placewang/HCF460/G294_PROJECT/数据手册/G294_V0.0-20201203.pdf

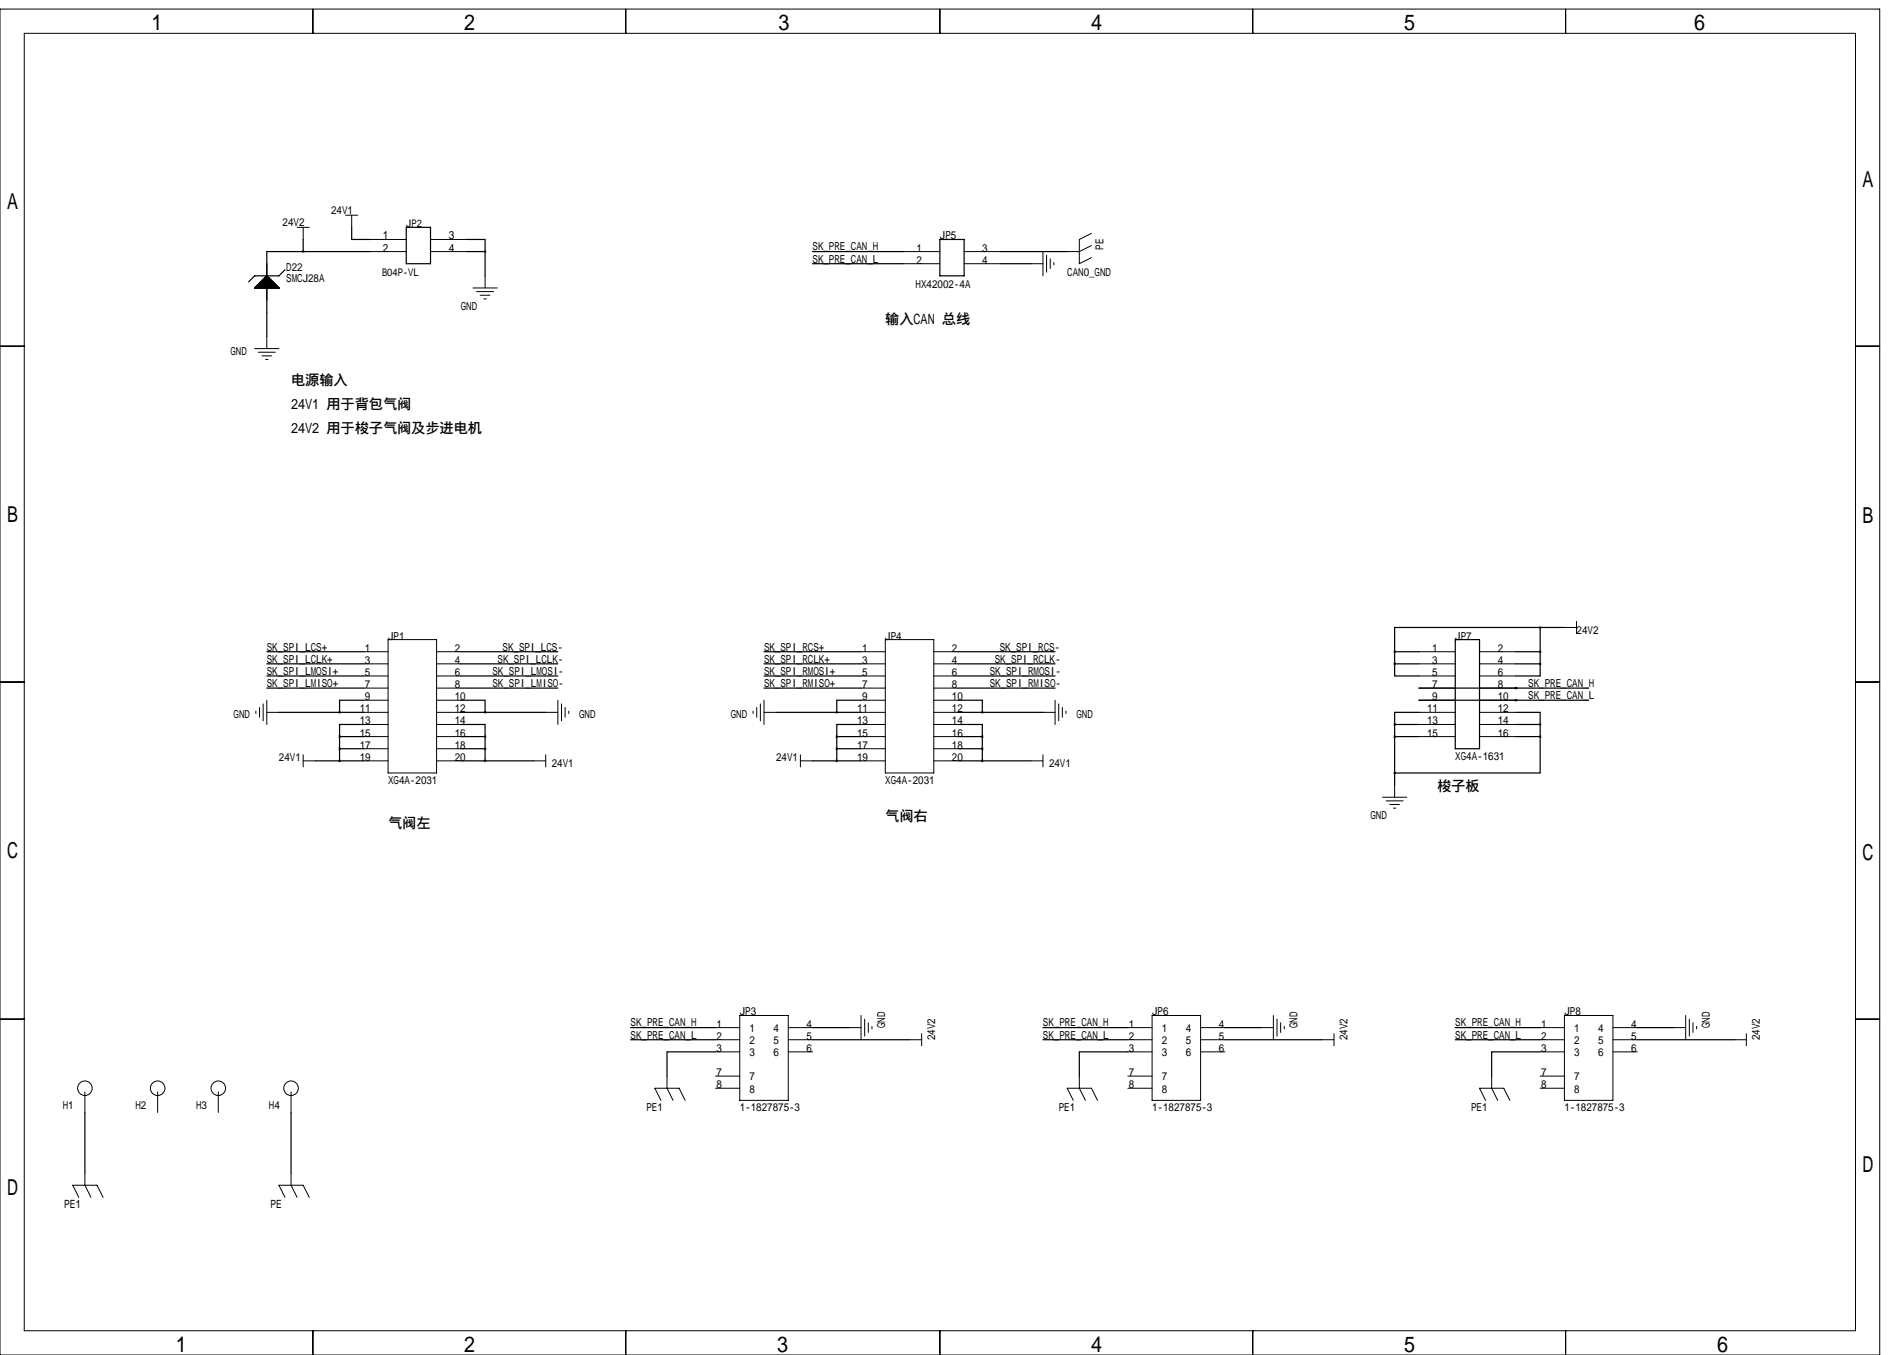
[picture p2: page 1]

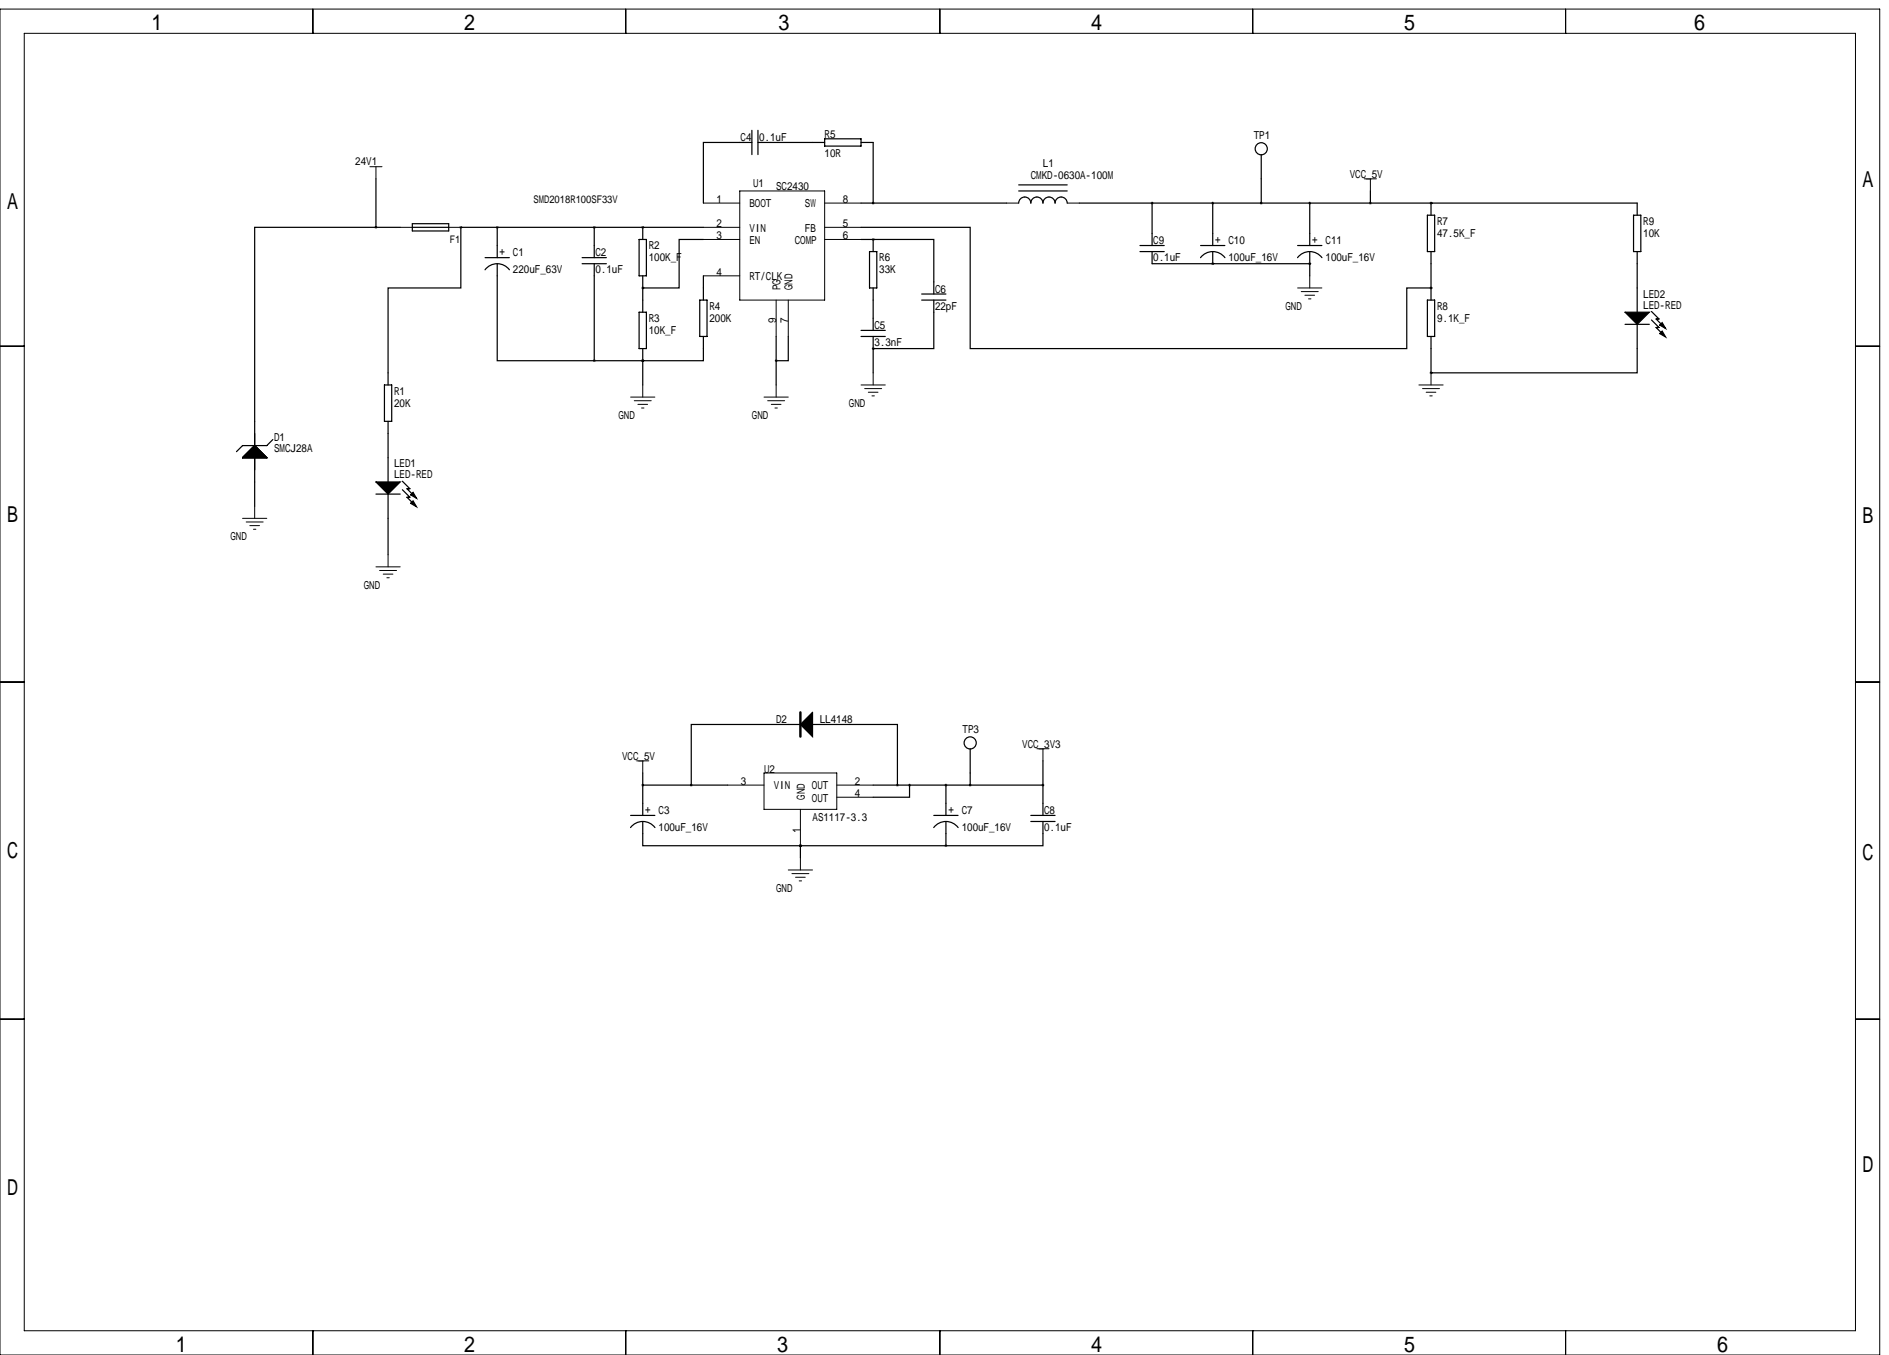
[picture p3: page 2]

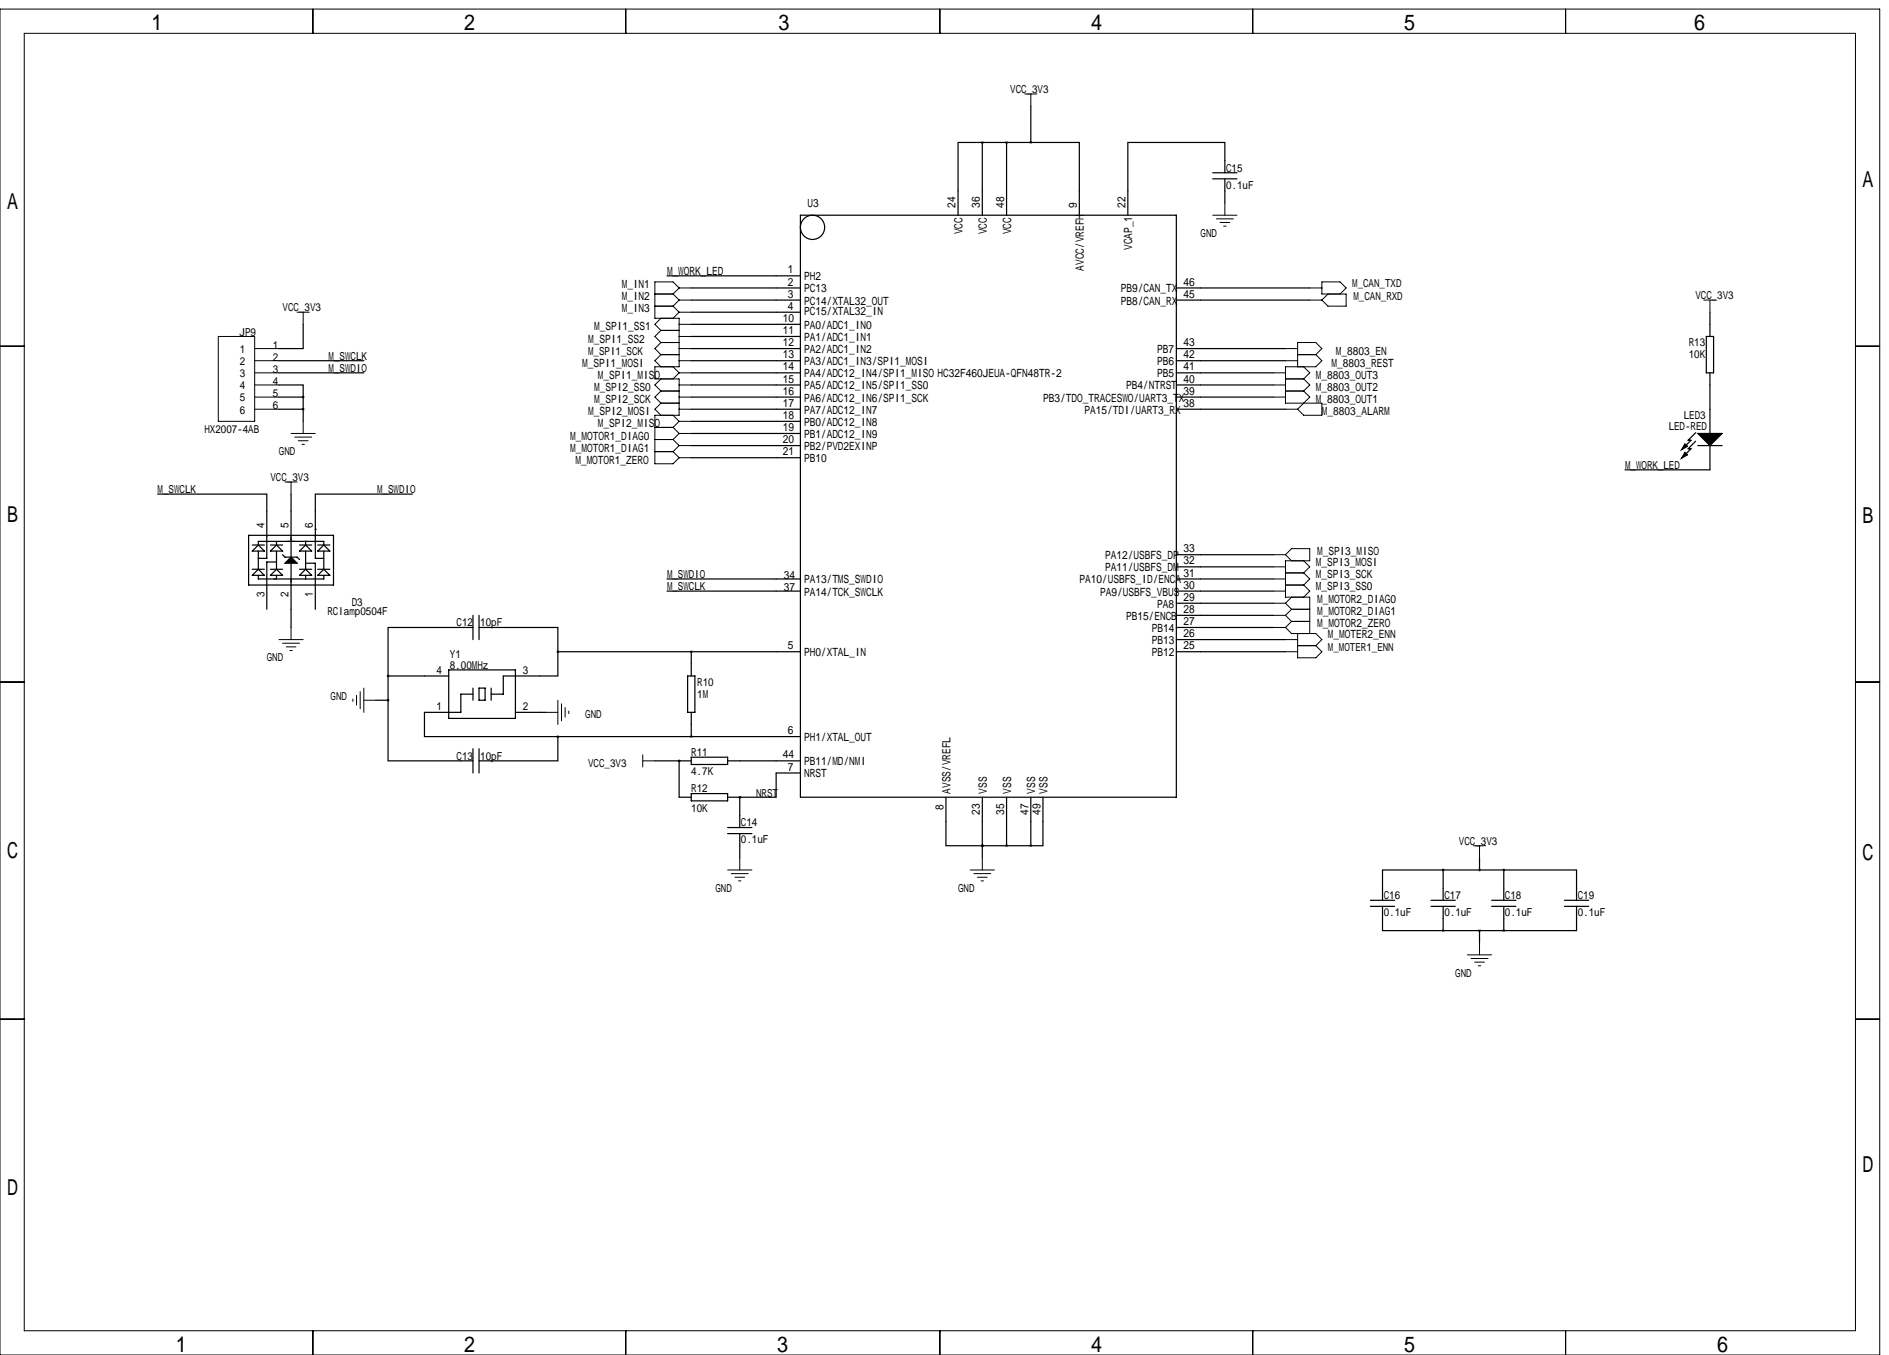
[picture p4: page 3]

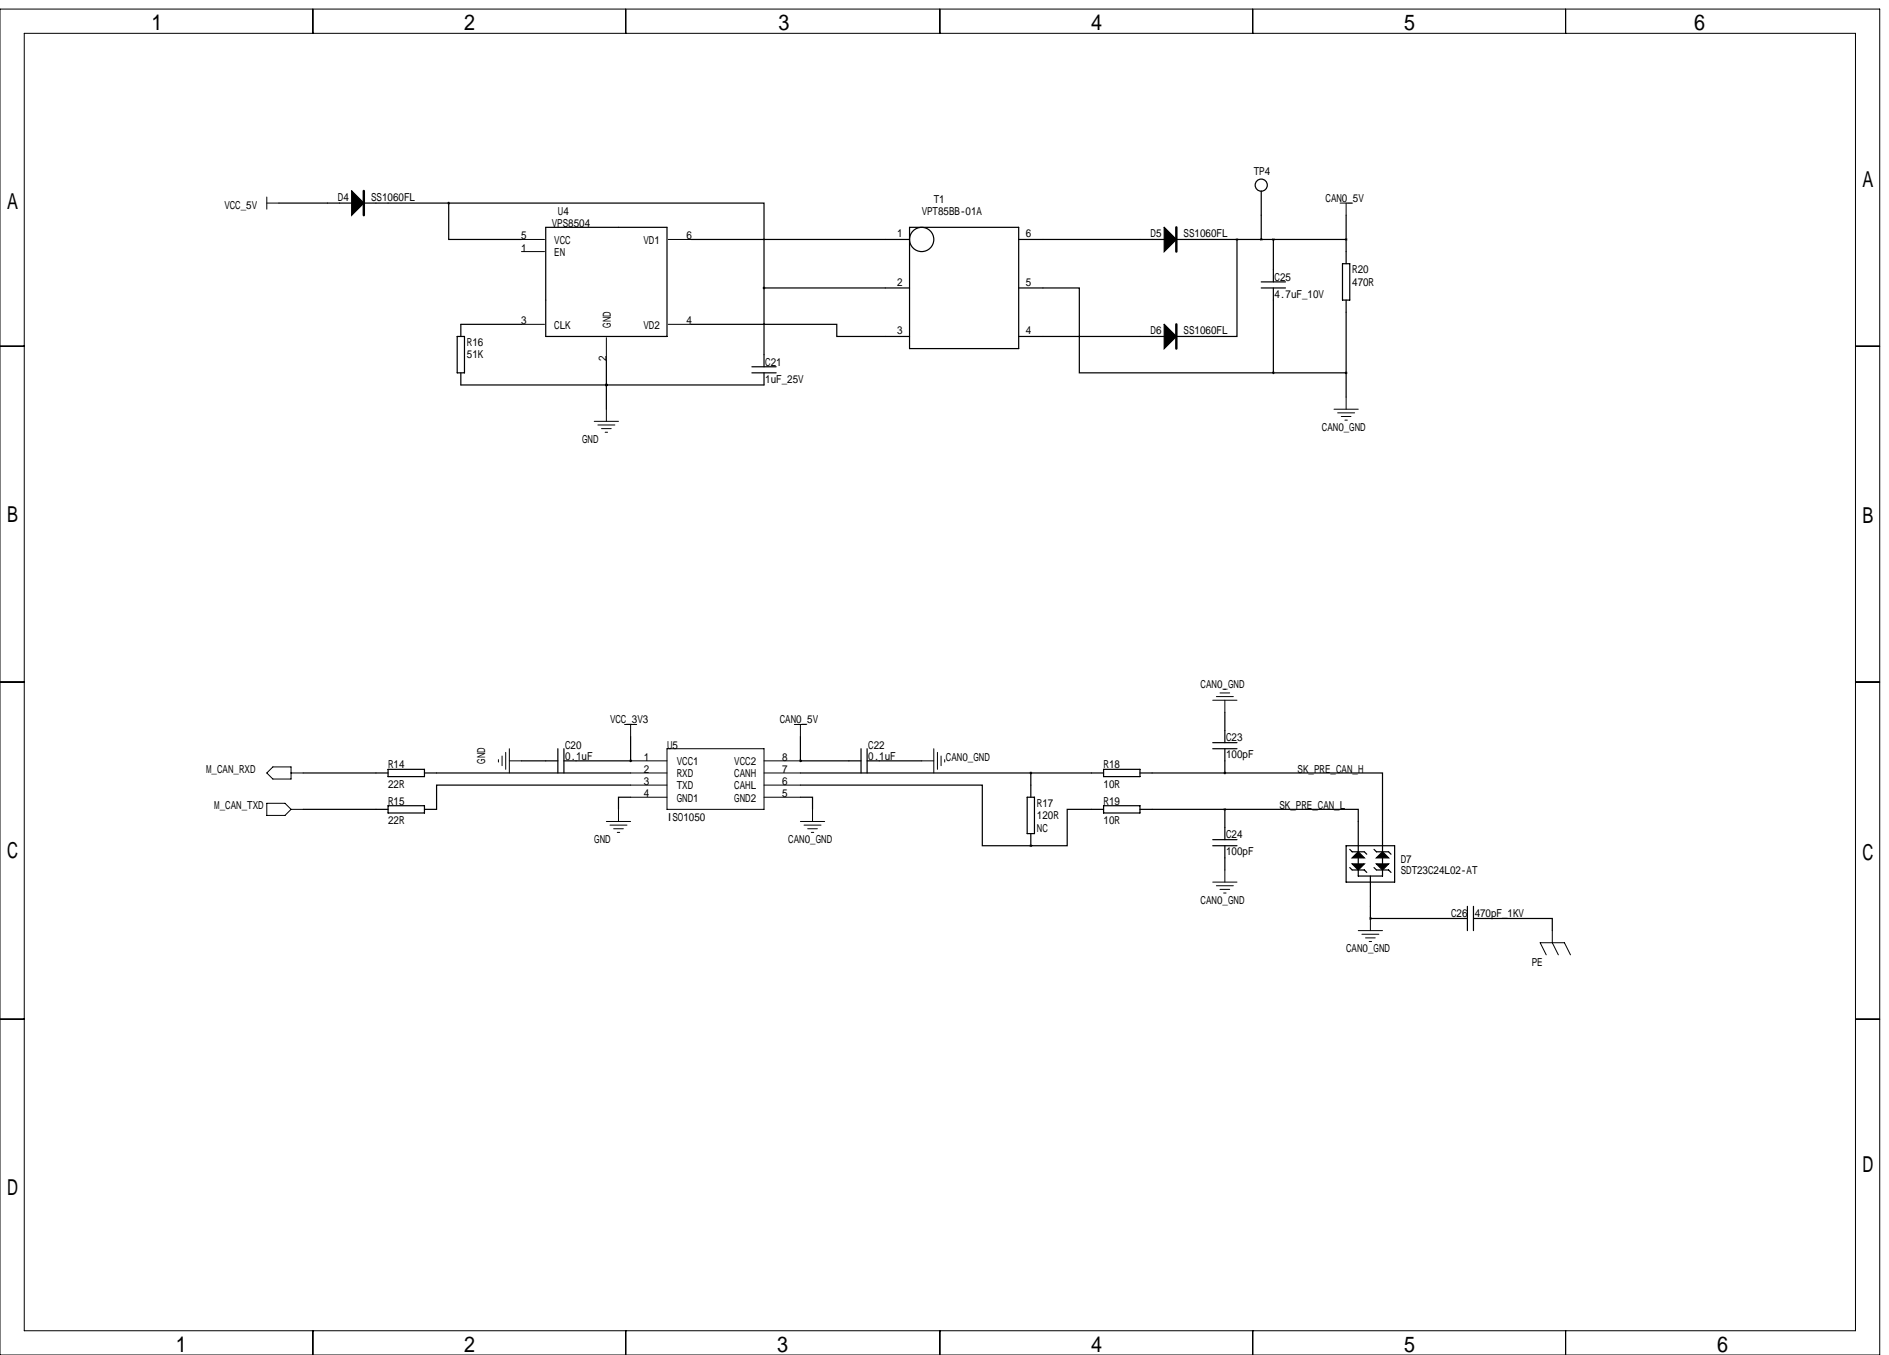
[picture p5: page 4]

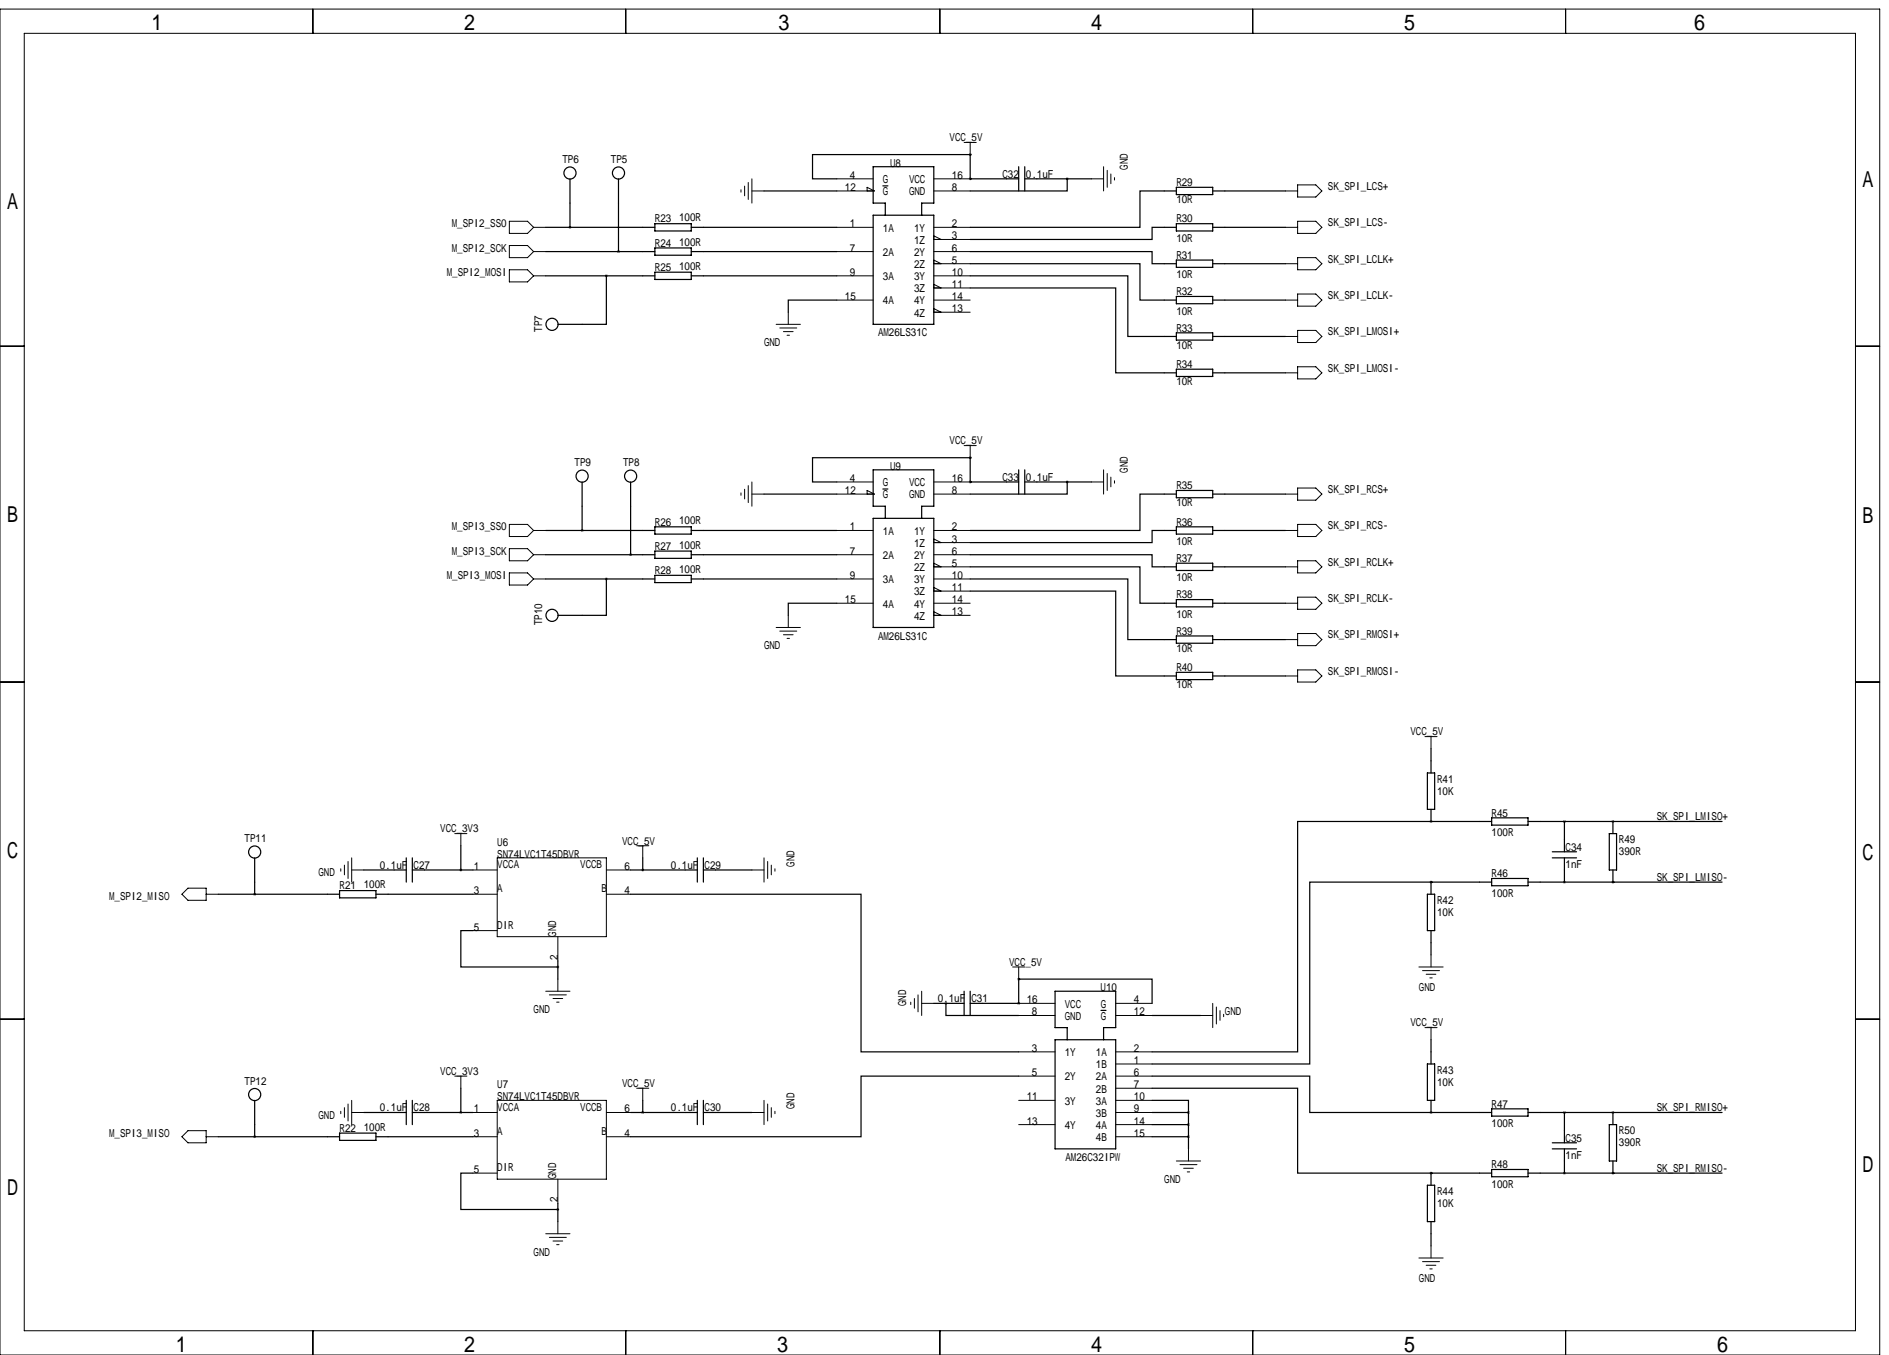
[picture p6: page 5]

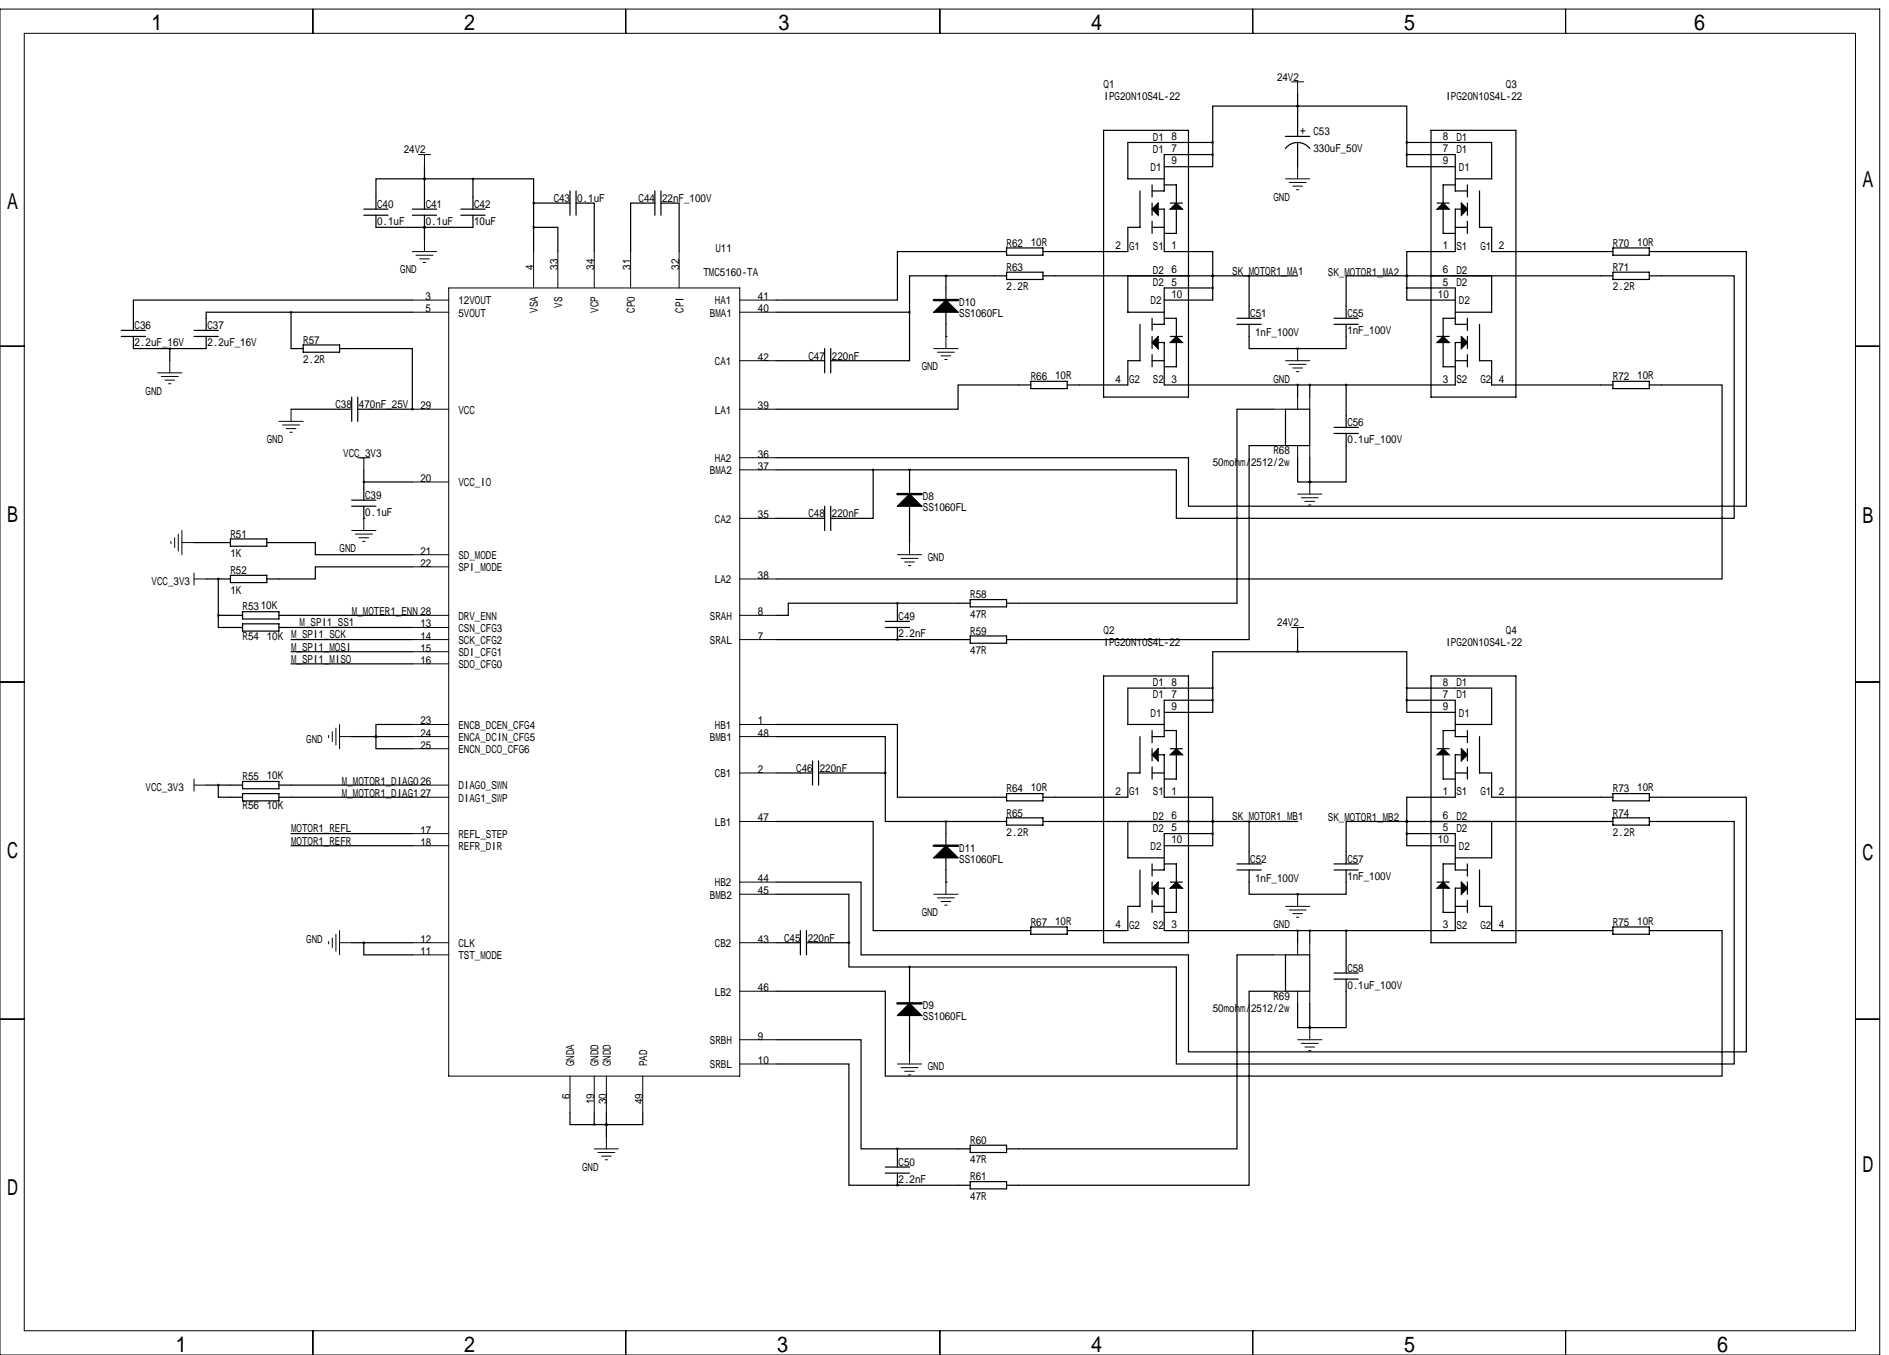
[picture p7: page 6]

24 | | 48
25

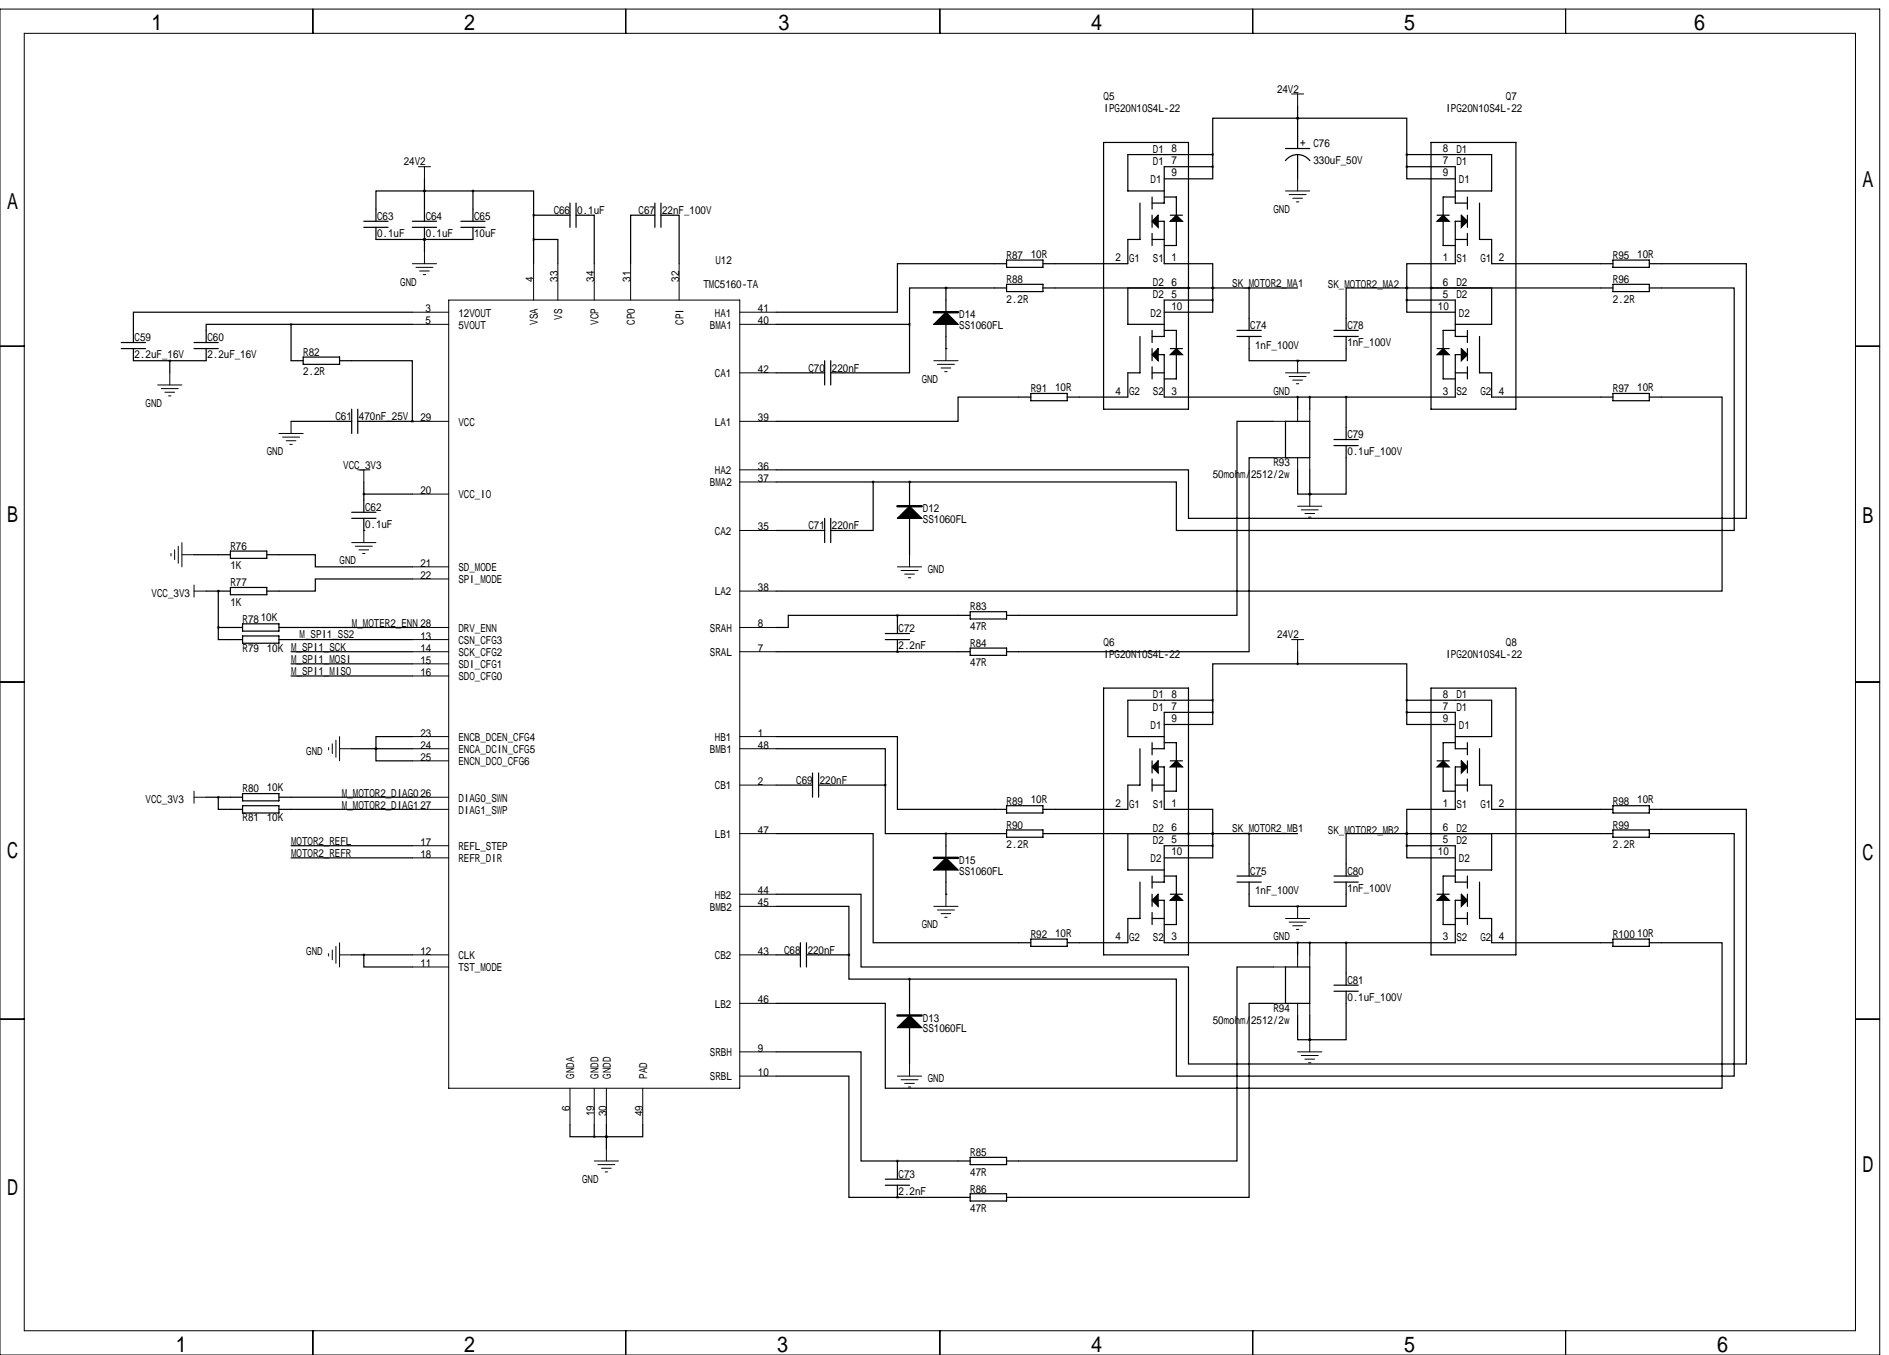
[picture p8: page 7]

GND

24 | | 48
25

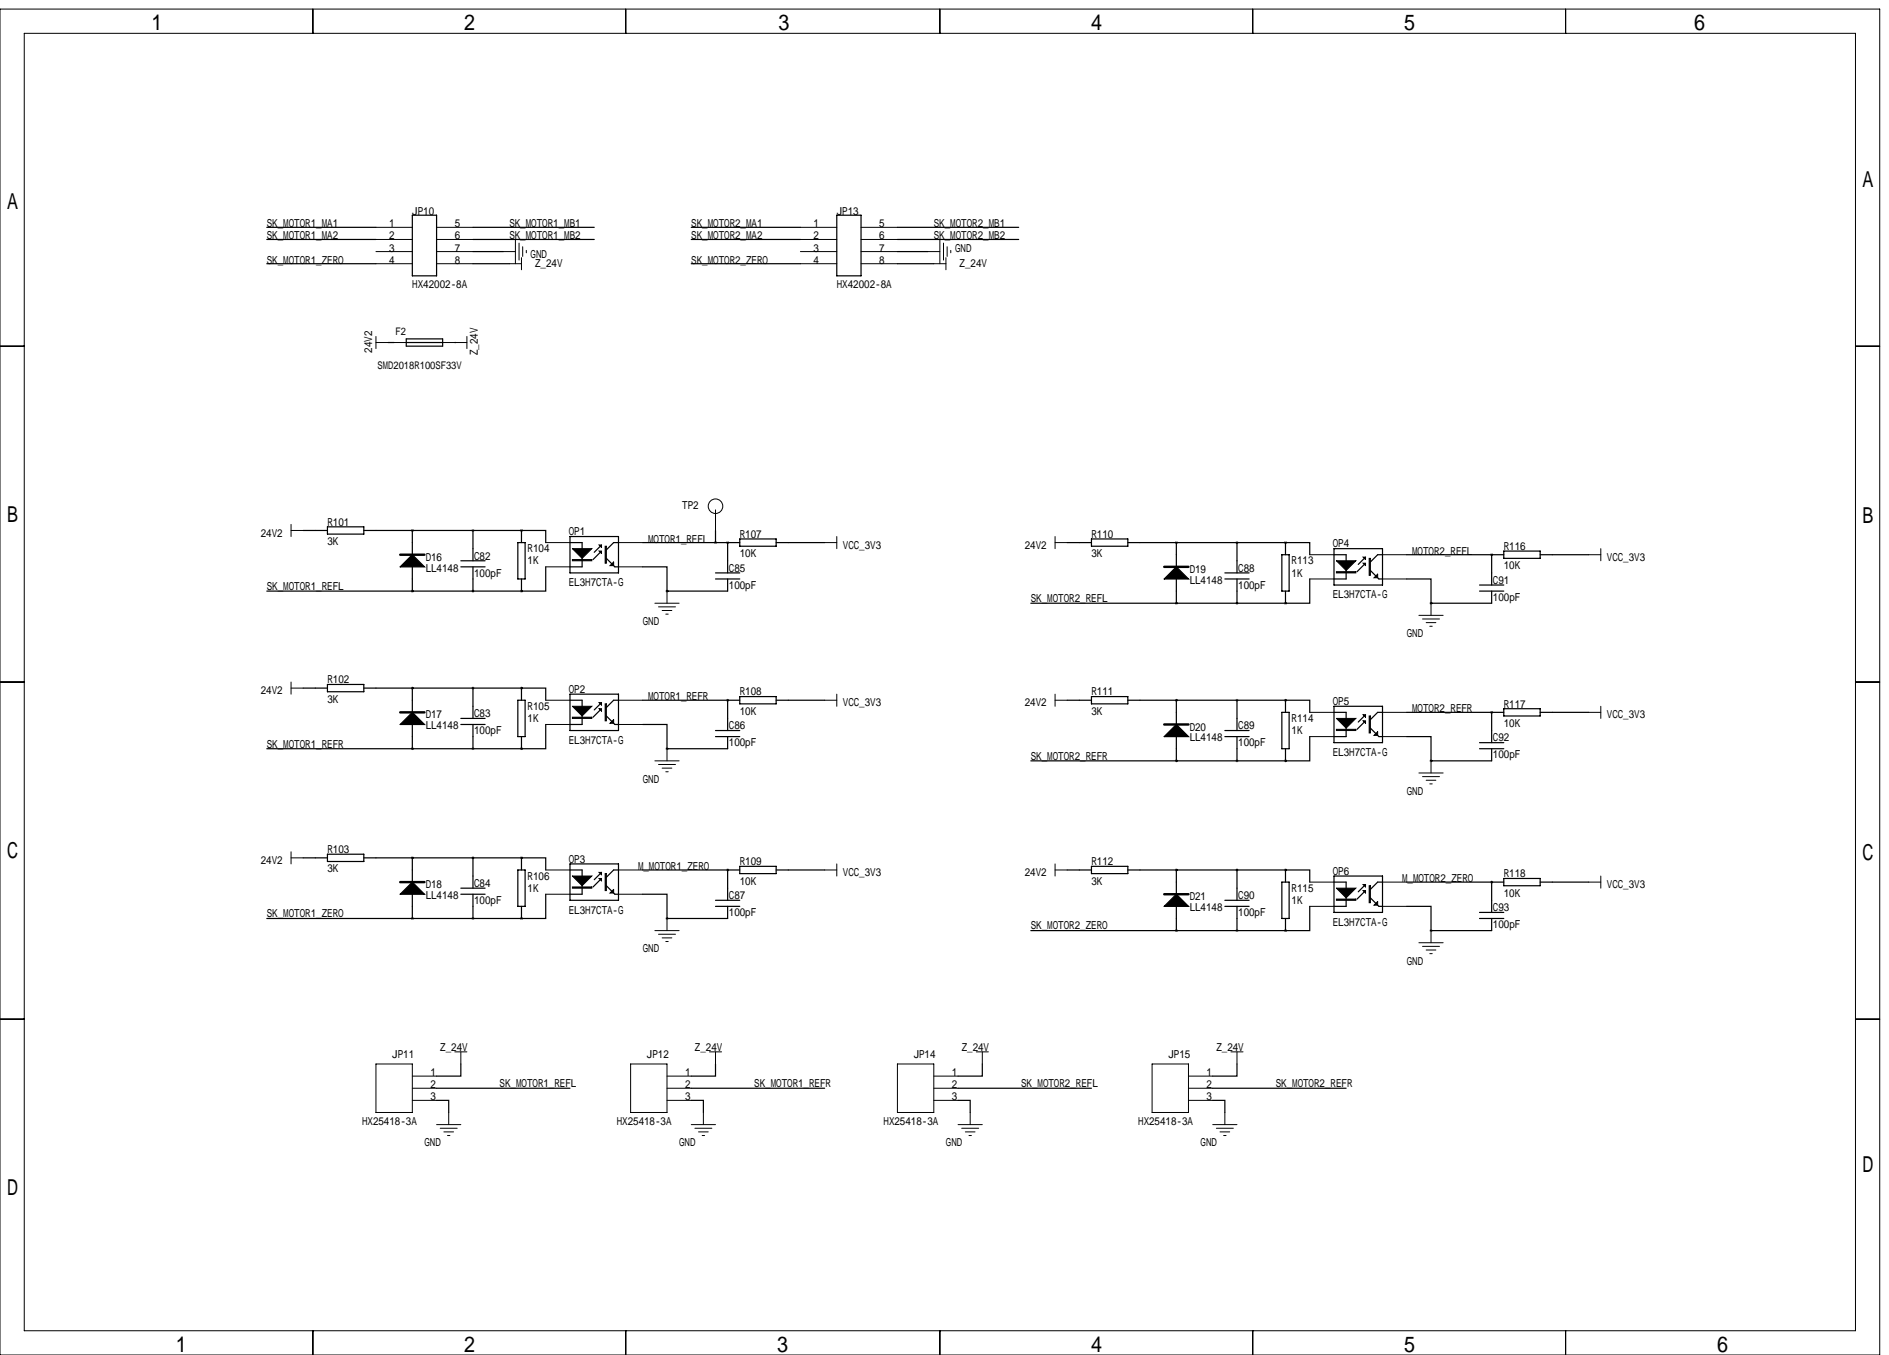
[picture p9: page 8]

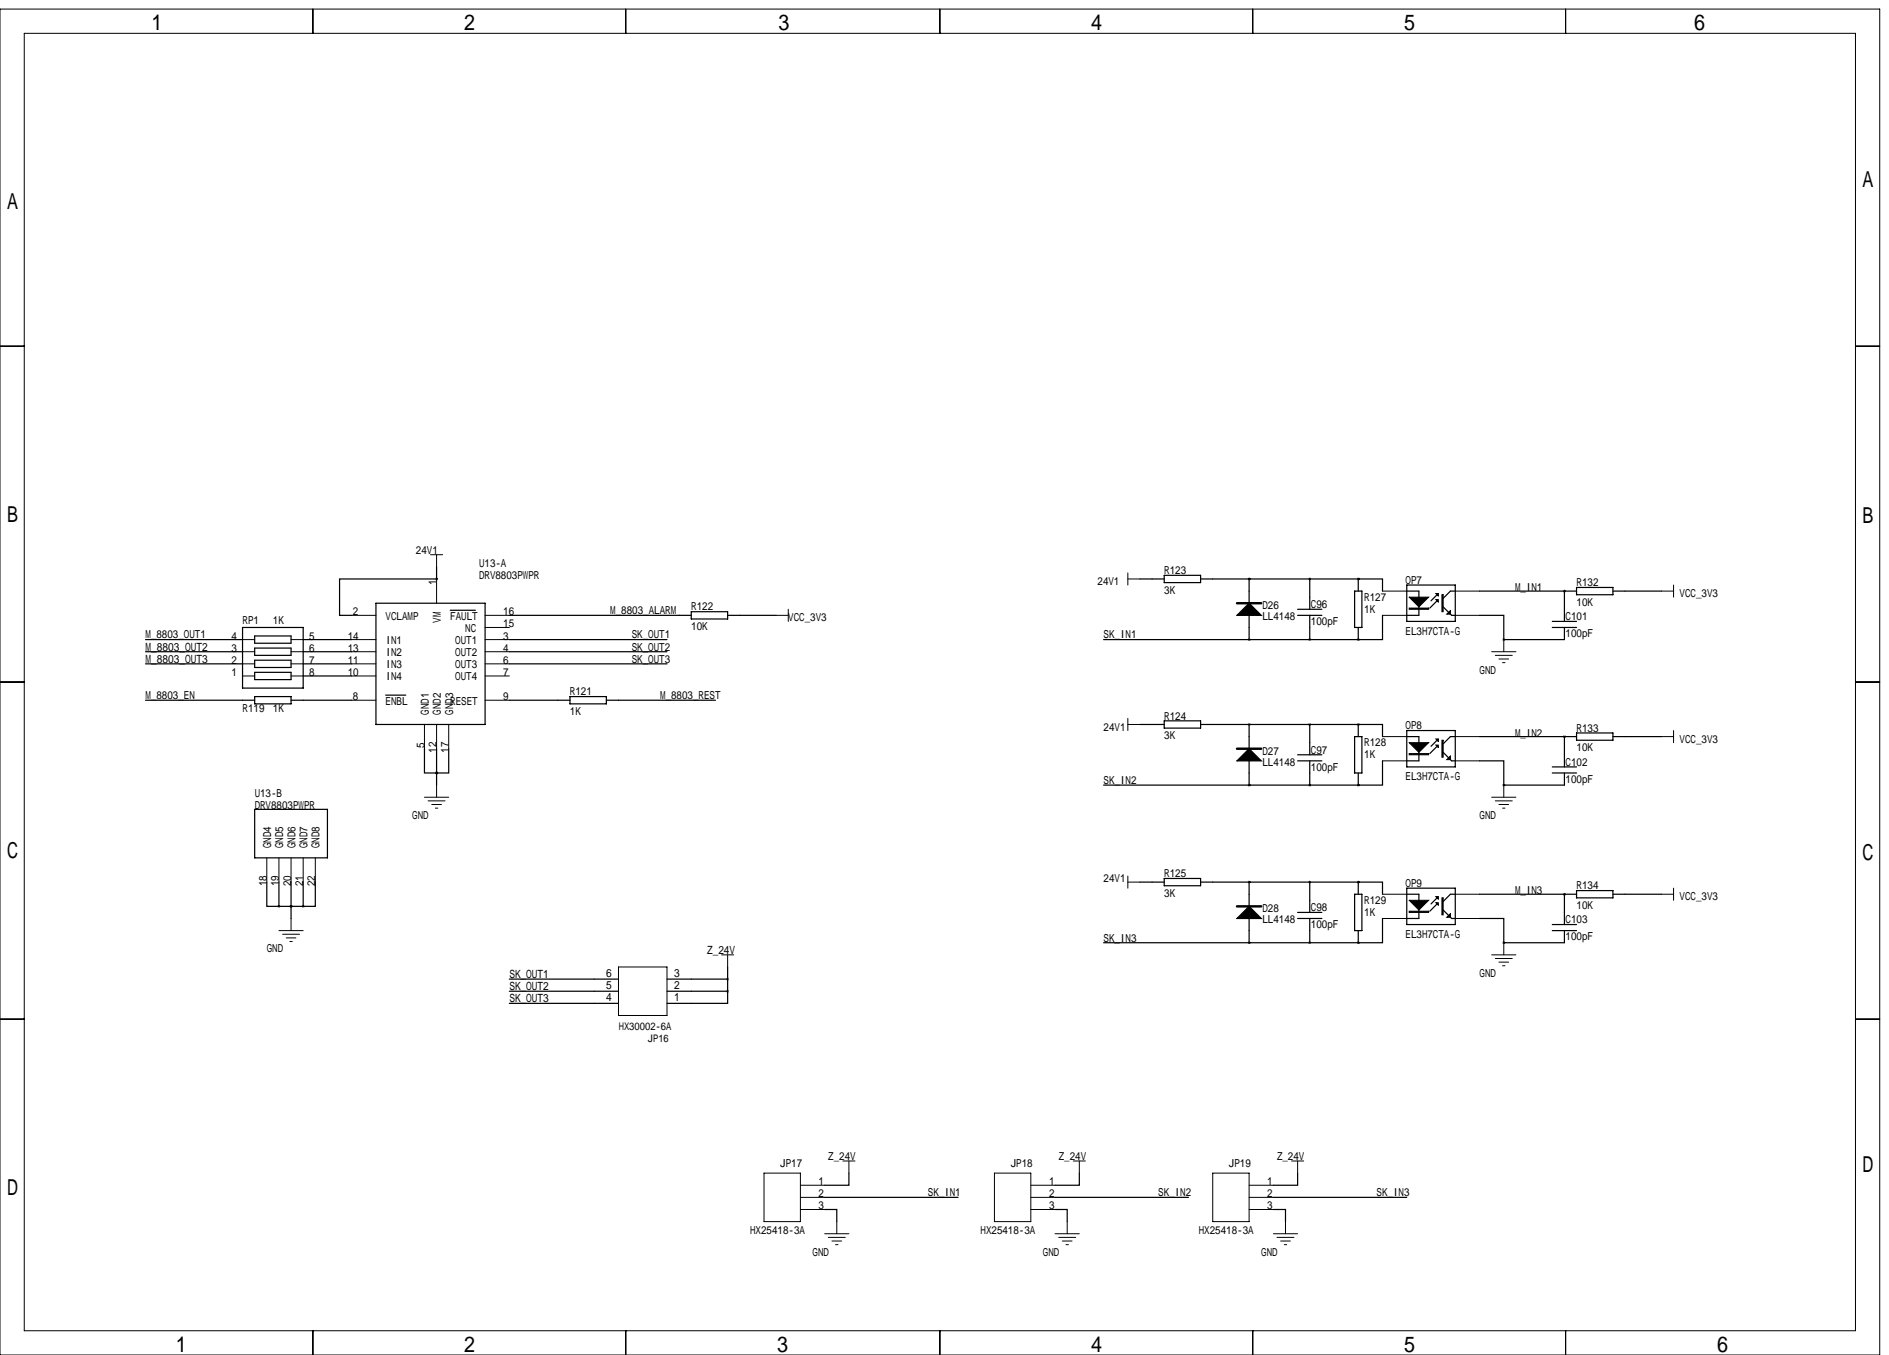
[picture p10: page 9]

13 | SK_OUT2
11 | SK_OUT3
10 | R121
