placewang/HCF460/G294_PROJECT/PRO_APP/example/pro/inout/source/tmc5610.h

#ifndef __TMC5610_H__
#define __TMC5610_H__

#define U8   unsigned char
#define U16  unsigned short
#define U32  unsigned int
    
#define SPI_CS_LOW 0
#define SPI_CS_HIGH 1

// ===== TMC5160 register set =====

#define TMC5160_GCONF          0x00
#define TMC5160_GSTAT          0x01
#define TMC5160_IFCNT          0x02
#define TMC5160_SLAVECONF      0x03
#define TMC5160_INP_OUT        0x04
#define TMC5160_X_COMPARE      0x05
#define TMC5160_OTP_PROG       0x06
#define TMC5160_OTP_READ       0x07
#define TMC5160_FACTORY_CONF   0x08
#define TMC5160_SHORT_CONF     0x09
#define TMC5160_DRV_CONF       0x0A
#define TMC5160_GLOBAL_SCALER  0x0B
#define TMC5160_OFFSET_READ    0x0C
#define TMC5160_IHOLD_IRUN     0x10
#define TMC5160_TPOWERDOWN     0x11
#define TMC5160_TSTEP          0x12
#define TMC5160_TPWMTHRS       0x13
#define TMC5160_TCOOLTHRS      0x14
#define TMC5160_THIGH          0x15

#define TMC5160_RAMPMODE       0x20
#define TMC5160_XACTUAL        0x21
#define TMC5160_VACTUAL        0x22
#define TMC5160_VSTART         0x23
#define TMC5160_A1             0x24
#define TMC5160_V1             0x25
#define TMC5160_AMAX           0x26
#define TMC5160_VMAX           0x27
#define TMC5160_DMAX           0x28
#define TMC5160_D1             0x2A
#define TMC5160_VSTOP          0x2B
#define TMC5160_TZEROWAIT      0x2C
#define TMC5160_XTARGET        0x2D

#define TMC5160_VDCMIN         0x33
#define TMC5160_SWMODE         0x34
#define TMC5160_RAMPSTAT       0x35
#define TMC5160_XLATCH         0x36
#define TMC5160_ENCMODE        0x38
#define TMC5160_XENC           0x39
#define TMC5160_ENC_CONST      0x3A
#define TMC5160_ENC_STATUS     0x3B
#define TMC5160_ENC_LATCH      0x3C
#define TMC5160_ENC_DEVIATION  0x3D

#define TMC5160_MSLUT0         0x60
#define TMC5160_MSLUT1         0x61
#define TMC5160_MSLUT2         0x62
#define TMC5160_MSLUT3         0x63
#define TMC5160_MSLUT4         0x64
#define TMC5160_MSLUT5         0x65
#define TMC5160_MSLUT6         0x66
#define TMC5160_MSLUT7         0x67
#define TMC5160_MSLUTSEL       0x68
#define TMC5160_MSLUTSTART     0x69
#define TMC5160_MSCNT          0x6A
#define TMC5160_MSCURACT       0x6B
#define TMC5160_CHOPCONF       0x6C
#define TMC5160_COOLCONF       0x6D
#define TMC5160_DCCTRL         0x6E
#define TMC5160_DRVSTATUS      0x6F
#define TMC5160_PWMCONF        0x70
#define TMC5160_PWMSCALE       0x71
#define TMC5160_PWM_AUTO       0x72
#define TMC5160_LOST_STEPS     0x73


void tmc5160_writeInt(U8 motor, U8 address, int value);

int tmc5160_readInt(U8 motor, U8 address);
void setPosition(U8 motor,int position);

int right(U8 motor, int velocity);

int left(U8 motor, int velocity);

int stop(U8 motor);

int moveTo(U8 motor, int position);
int moveBy(U8 motor, int *ticks);
void setspeed(U8 motor,int speed);


unsigned short tmc5160_spi_status(void);
void tmc5160_writeDatagram(U8 motor, U8 address, U8 x1, U8 x2, U8 x3, U8 x4);
void spi_err_register(void (*callback)(U8));

#endif
