placewang/HCF460/G294_PROJECT/PRO_APP/example/pro/inout/modbus/mb_hook.c

#include "mb_include.h"

void mbh_hook_rec01(uint8_t add,uint8_t *data,uint8_t datalen)
{

}
void mbh_hook_rec02(uint8_t add,uint8_t *data,uint8_t datalen)
{

}
void mbh_hook_rec03(uint8_t add,uint8_t *data,uint8_t datalen)
{

}
void mbh_hook_rec04(uint8_t add,uint8_t *data,uint8_t datalen)
{

}
void mbh_hook_rec05(uint8_t add,uint8_t *data,uint8_t datalen)
{

}
void mbh_hook_rec06(uint8_t add,uint8_t *data,uint8_t datalen)
{

}
void mbh_hook_rec15(uint8_t add,uint8_t *data,uint8_t datalen)
{

}
void mbh_hook_rec16(uint8_t add,uint8_t *data,uint8_t datalen)
{

}


void mbh_hook_timesErr(uint8_t add,uint8_t cmd)
{
	
}
