placewang/HCF460/G294_PROJECT/PRO_APP/example/pro/inout/source/machconfig.c

#include "machconfig.h"


#define M_ENABLE  1
#define M_DISABLE 0

const _BOARDDEF boarddef[BOARDTYPE_N]=
{
 {0x0294},
 {0xFFFF},
 {0xFFFF},
 {0xFFFF},
 {0xFFFF},
 {0xFFFF},
 {0xFFFF},
 {0xFFFF},
 {0xFFFF},
 {0xFFFF},
};
