placewang/HCF460/G294_PROJECT/PRO_APP/example/pro/inout/source/upgrade.h

#ifndef __UPGRADE_H
#define __UPGRADE_H
#include "machconfig.h"

#define SECTOR_SIZE    0x2000

#define SONBOARD_SECTOR_SIZE 0x200


#define ADDR_APP_BACKUP         0x50000  //APP备份区  320K开始

#define CMD_UPGRADE_START	0xA050AA00
#define CMD_UPGRADE_RCVDATA	0xA050AA55
#define CMD_UPGRADE_BURN	0xA0505A5A
#define CMD_UPGRADE_SUCCESS	0xA05055AA


#define UPGRADE_BOARDTYPE   0x30    //接收到需要升级的子板类型   new add
#define UPGRADE_REQUEST		0x3A	/* 升级命令 */ 
#define UPGRADE_DATA		0x3B	/* 升级命令 */ 
#define UPGRADE_ENDDATA		0x3C	/* 升级命令 */ 
#define UPGRADE_DATA_RECEIVED	0x3D	/* 升级命令 */ 
#define UPGRADE_SUCCESS		0x3E	/* 升级命令 */ 
#define UPGRADE_FORCE_REQ	0x3F	/* 升级命令 */ 

enum
{
  NO_ERROR_2,
  FLASH_ERROR,
  PACK_ERROR,
  NO_UPGRADE = 6,
  CRC_ERROR_2,
  CRC_FLAG_ERROR
};

enum
{   
 UPGRADE_PHASE_PREPARE=1,
 UPGRADE_PHASE_GOBOOT=2,
 UPGRADE_PHASE_WAITAPPBOOT=3,
 UPGRADE_PHASE_ERASE=4,
 UPGRADE_PHASE_STARTUPG=5,
 UPGRADE_PHASE_ENDUPG=6,
 UPGRADE_PHASE_CHECKSUCCESS=7,
};








#define UPGRADE_DATA_RECEIVEDERR	0x013D	/* 升级命令--接收数据出错 */ 
#define UPGRADE_DATA_RECEIVEDAPPVER_LOW	0x023D	/* 升级命令--接收数据出错 */ 
#define UPGRADE_DATA_RECEIVEDAPPCRC_ERROR	0x033D	/* 升级命令--CRC校验出错 */ 

extern unsigned short canid_upgrade;
extern unsigned short canid_upgrade_rx;
extern unsigned short canid_upgrade_tx;
extern int timdelay_upgrade;
extern void UpgradeSonBoardLoop(void);
extern void UpgradeInitDeal(uint16_t boardtype);
extern void NewSonBoardUpGradeLoop(void);
#endif
