placewang/HCF460/G294_PROJECT/PRO_BOOT/example/pro/inout/source/machconfig.h

#ifndef __MACHCONFIG_H__
#define __MACHCONFIG_H__
#include "bsp.h"

 #define ACTEMG_REMAP6TO4

 #define XZQ_TYPE_BASE         XZQ_LEFT_BACK    
 #define MOT_DENSITY_TYPE_BASE MOT_DENSITY_LEFT_BACK    
 #define MOT_SKINER_TYPE_BASE  MOT_SKINER_BACK 
 #define MOT_ACTION_TYPE_BASE  MOT_ACTION_BACK   
 #define MOT_FEET_TYPE_BASE    MOT_FEET_BACK  
 #define MOT_LIFT_TYPE_BASE    MOT_LIFT_BACK    
 #define MOTEMG_SZ_TYPE_BASE   MOT_YARN  
 #define ACTEMG_TYPE_BASE      EMG_ACT 
    



extern const NEWSYSCONFIG config_aoxiang;
extern const NEWSYSCONFIG config_cixing;
#endif
